ai-systems-lab/MemArdBoard/commutatuin-board/schematic/SCH_ISC_UNO_COMM_FLOOR.pdf

# S7 10 S6 11 S5 12 VDD 13 GND 14 A2 15 A1 16

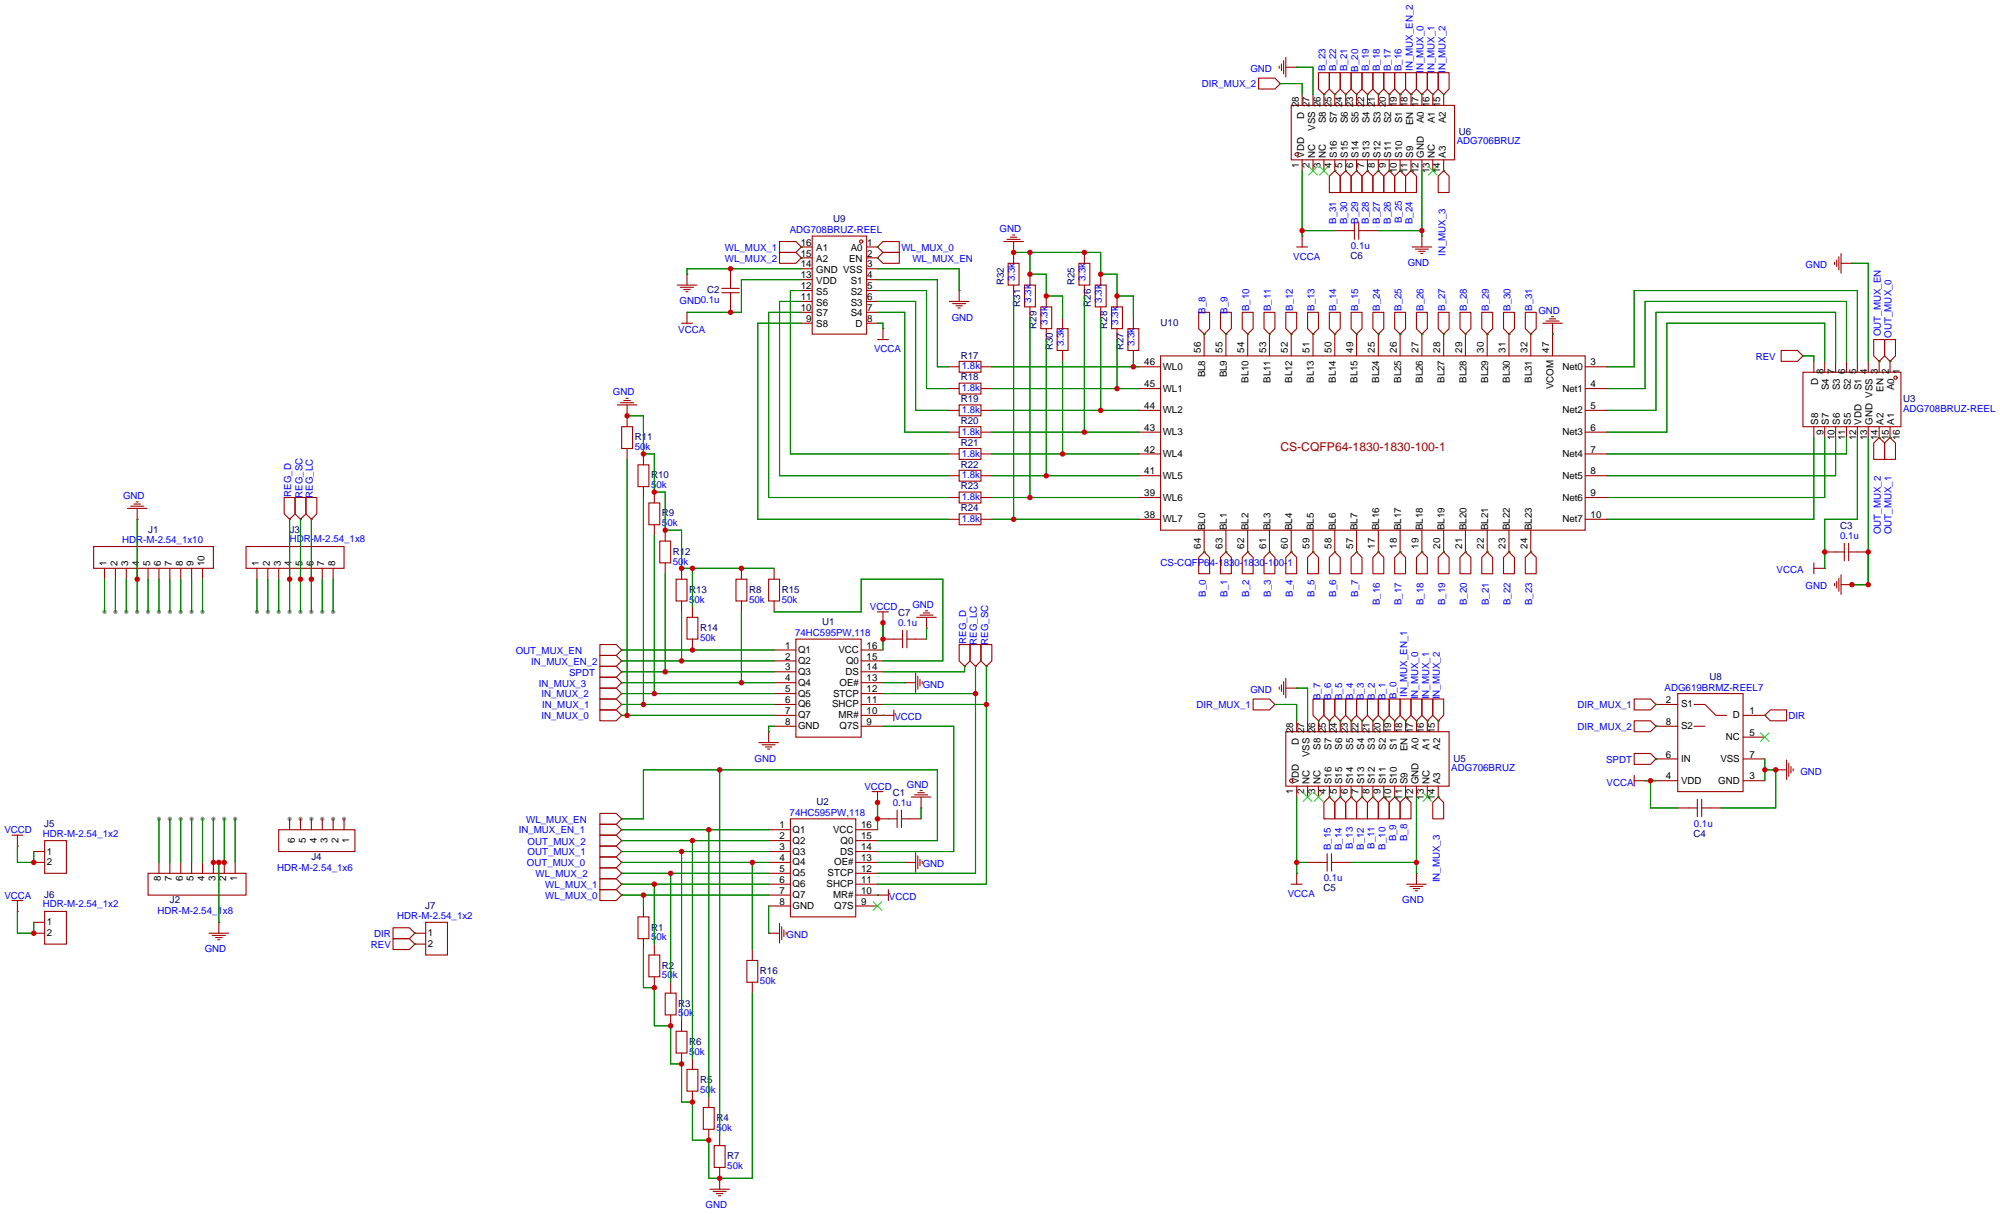
[picture p1: page 1]

MR# 10 SHCP 11 STCP 12 OE# 13 DS 14 Q0 15 VCC 16
