ai-systems-lab/MemArdBoard/commutatuin-board/schematic/PCB_ISC__COMM_FLOOR.pdf

U2

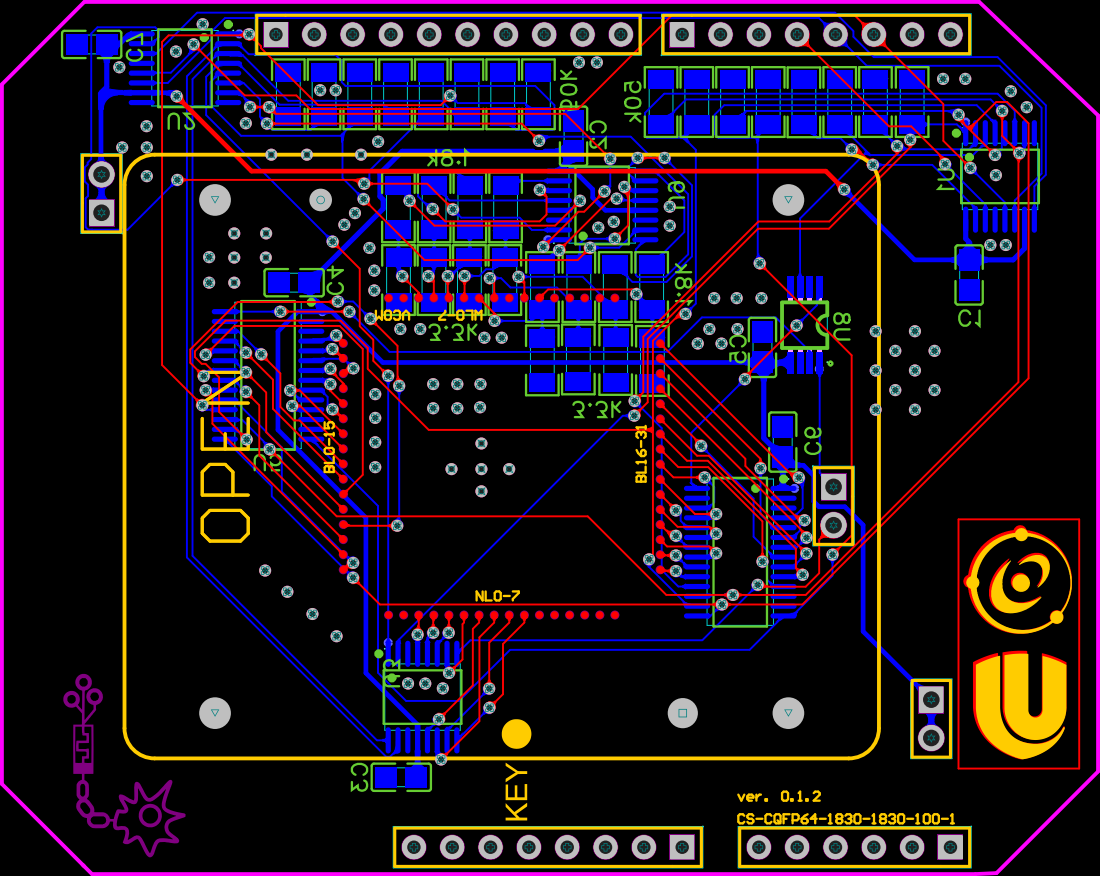
[picture p2: page 1]

1.8k

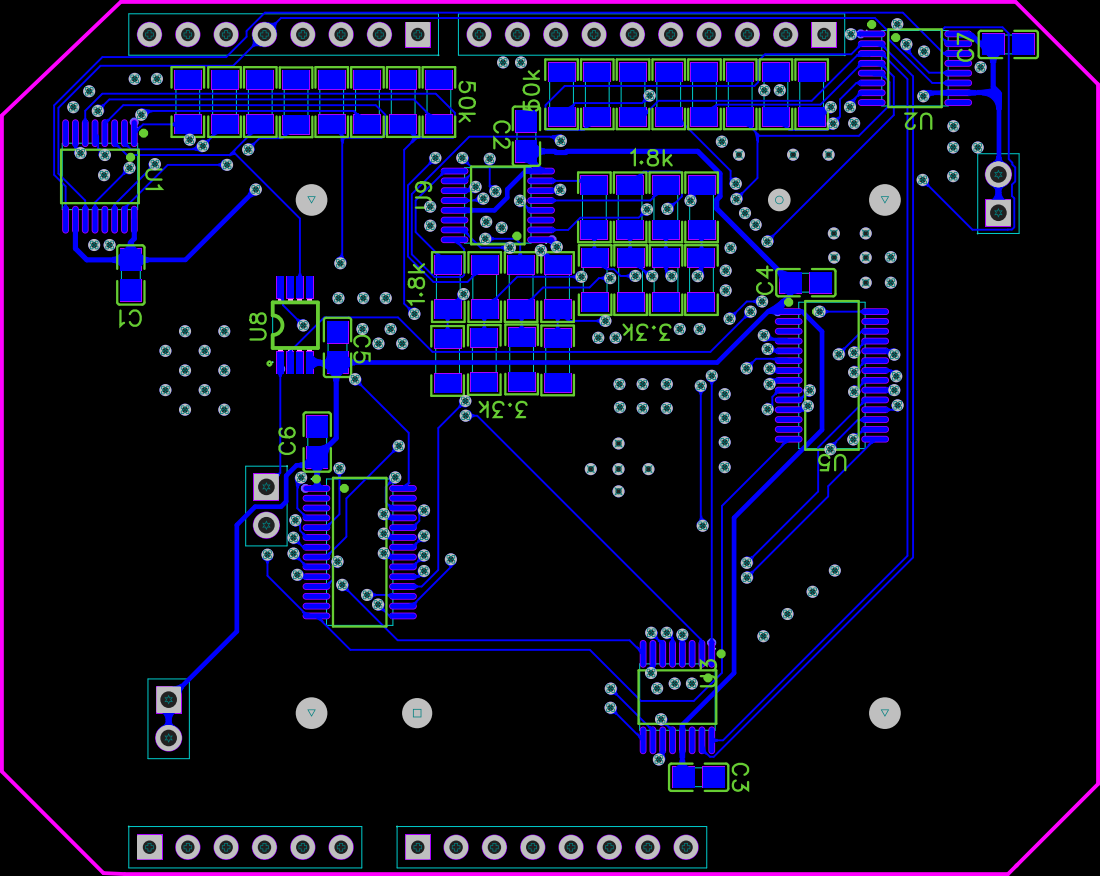
[picture p3: page 2]
