ai-systems-lab/MemArdBoard/signal-board/schematic/PCB_UNO_SIGNAL_FLOOR.pdf

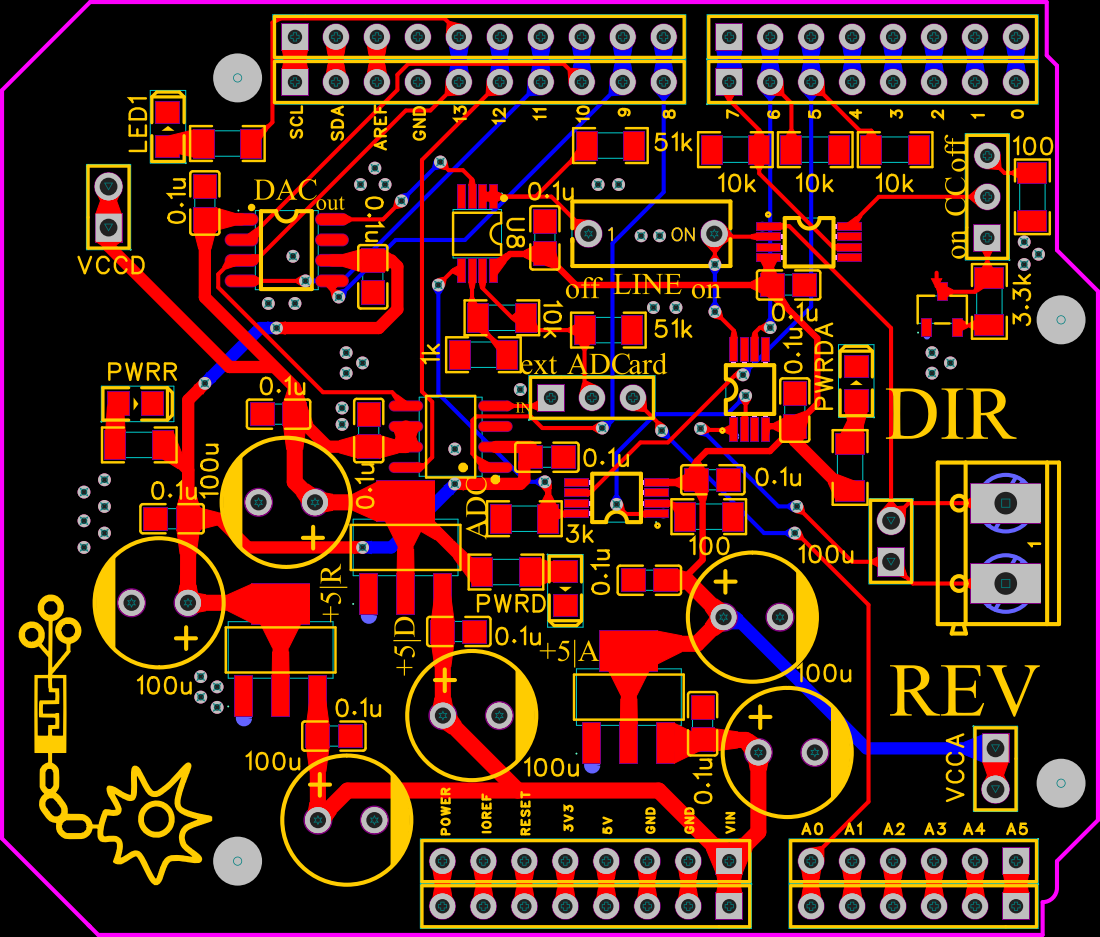
[picture p4: page 1]

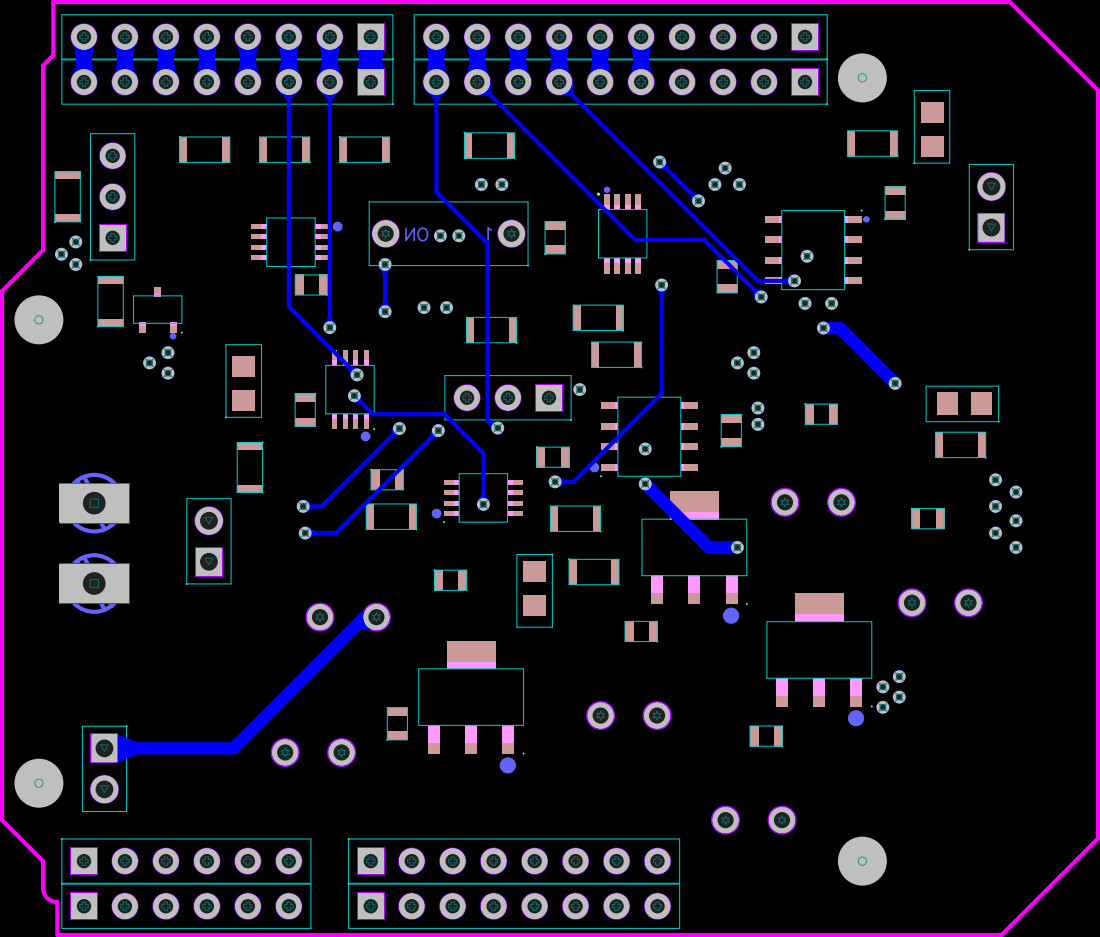
[picture p5: page 2]
