ai-systems-lab/MemArdBoard/signal-board/schematic/SCH_UNO_SIGNAL_FLOOR.pdf

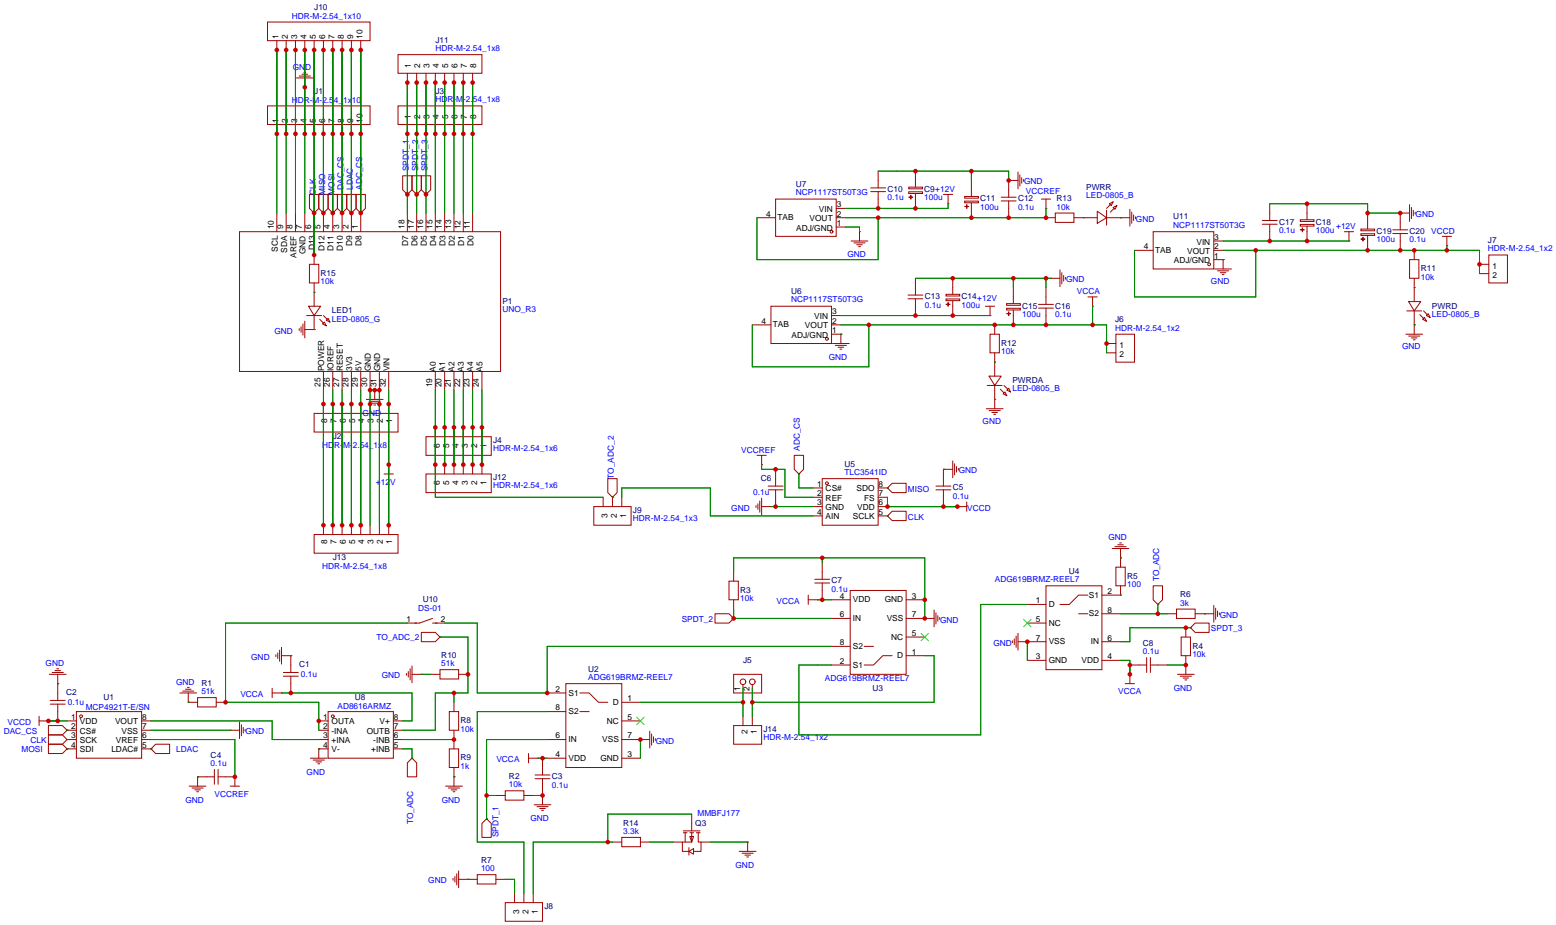
[picture p6: page 1]
