ai-systems-lab/MemArdBoard/(list of files, drawings)

Other design files:
commutatuin-board/schematic/ProPrj_UNO2FL32x8_COMM_pro_2026-06-11.epro
signal-board/schematic/ProPrj_UNO_SIG_pro_2026-06-11.epro
